obono/ArduinoACePCalendar/doc/schematic.png

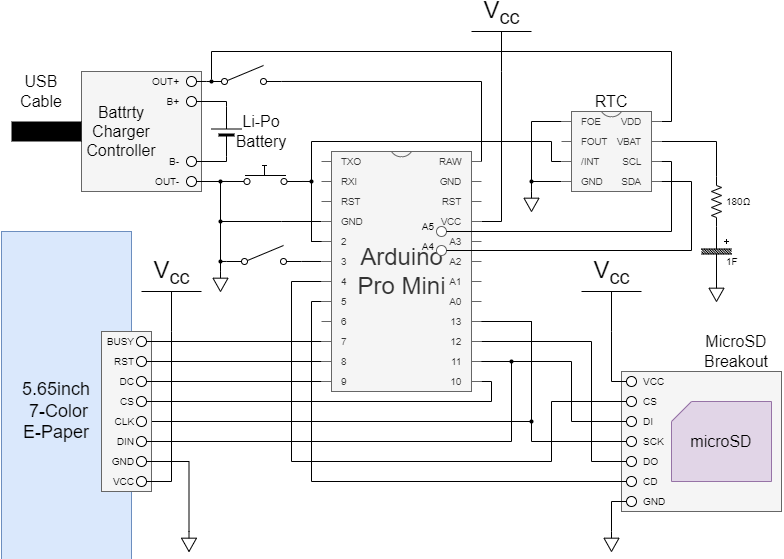
doc/schematic.png
