obono/ArduinoACePCalendar/tools/sample0.jpg

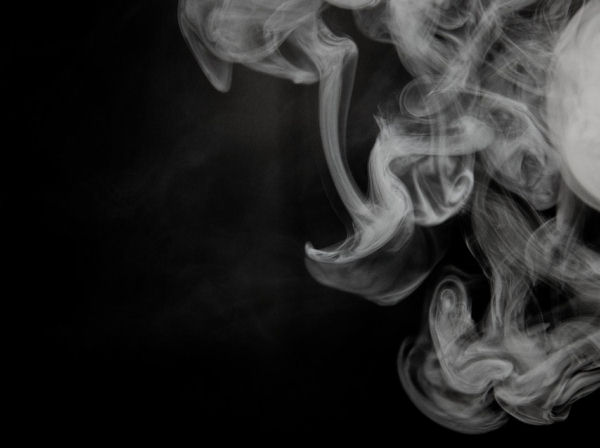
tools/sample0.jpg
