obono/ArduinoACePCalendar/tools/sample1.jpg

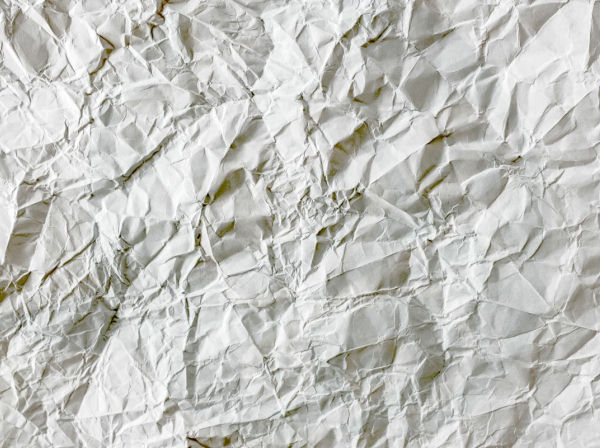
tools/sample1.jpg
