obono/ArduinoACePCalendar/tools/sample2.jpg

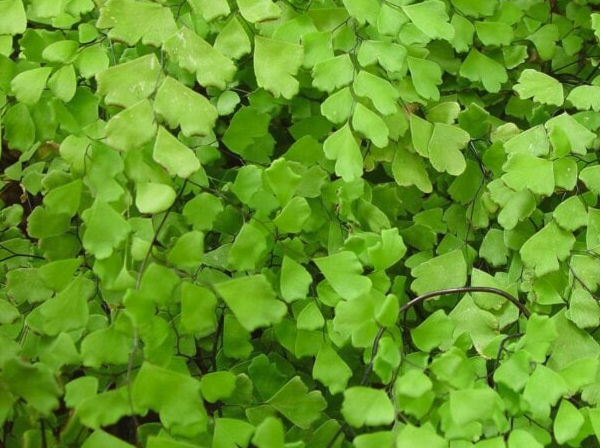
tools/sample2.jpg
