obono/ArduinoACePCalendar/tools/sample3.jpg

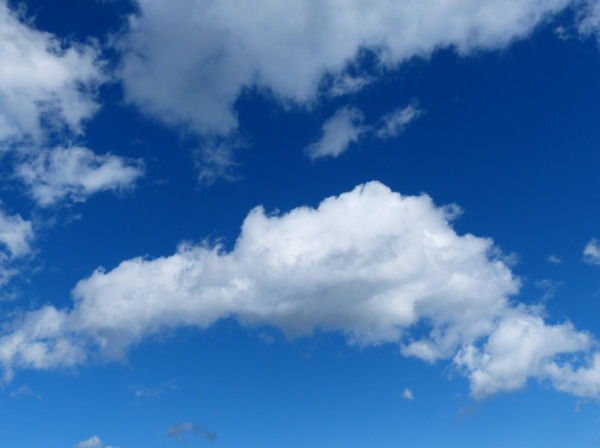
tools/sample3.jpg
