obono/ArduinoACePCalendar/tools/sample4.jpg

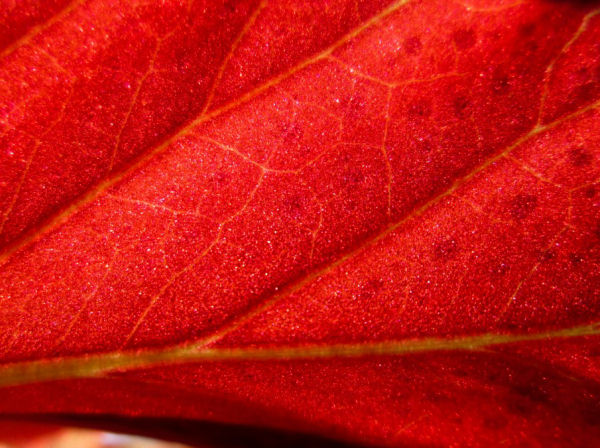
tools/sample4.jpg
