obono/ArduinoACePCalendar/tools/sample5.jpg

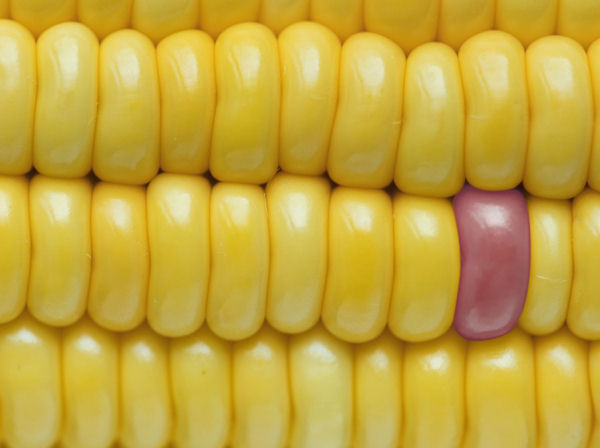
tools/sample5.jpg
