obono/ArduinoACePCalendar/tools/sample6.jpg

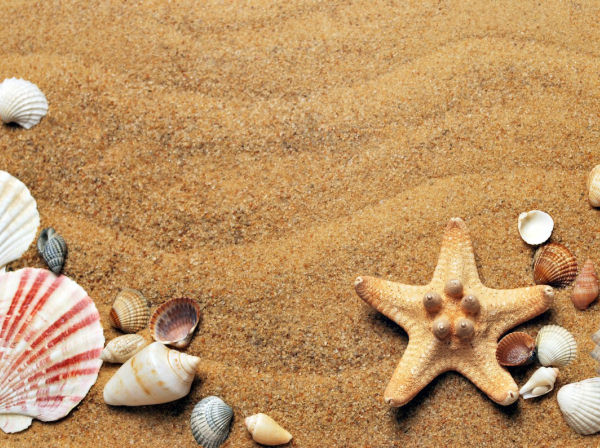
tools/sample6.jpg
