obono/ArduinoACePCalendar/imagedata.h

/**
 * ArduinoACePCalendar : "imagedata.h"
 *
 * Copyright (c) 2022 OBONO
 *
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
 * THE SOFTWARE IS PROVIDED "AS IS", WITHOUT WARRANTY OF ANY KIND, EXPRESS OR
 * IMPLIED, INCLUDING BUT NOT LIMITED TO THE WARRANTIES OF MERCHANTABILITY,
 * FITNESS FOR A PARTICULAR PURPOSE AND NONINFRINGEMENT. IN NO EVENT SHALL THE
 * AUTHORS OR COPYRIGHT HOLDERS BE LIABLE FOR ANY CLAIM, DAMAGES OR OTHER
 * LIABILITY, WHETHER IN AN ACTION OF CONTRACT, TORT OR OTHERWISE, ARISING FROM,
 * OUT OF OR IN CONNECTION WITH THE SOFTWARE OR THE USE OR OTHER DEALINGS IN THE
 * SOFTWARE.
 */

#pragma once

enum : uint8_t {
    IMG_ID_NUMBER_0 = 0,
    IMG_ID_NUMBER_1,
    IMG_ID_NUMBER_2,
    IMG_ID_NUMBER_3,
    IMG_ID_NUMBER_4,
    IMG_ID_NUMBER_5,
    IMG_ID_NUMBER_6,
    IMG_ID_NUMBER_7,
    IMG_ID_NUMBER_8,
    IMG_ID_NUMBER_9,
    IMG_ID_KANJI_SUN,
    IMG_ID_KANJI_MON,
    IMG_ID_KANJI_TUE,
    IMG_ID_KANJI_WED,
    IMG_ID_KANJI_THU,
    IMG_ID_KANJI_FRI,
    IMG_ID_KANJI_SAT,
    IMG_ID_KANJI_YEAR,
    IMG_ID_BRACKET_L,
    IMG_ID_BRACKET_R,
    IMG_ID_KANJI_DAY = IMG_ID_KANJI_SUN,
    IMG_ID_KANJI_MONTH = IMG_ID_KANJI_MON,
    IMG_ID_BLANK = 255,
 };

#define IMG_LETTER_W    32
#define IMG_NUMBER_H    48
#define IMG_KANJI_H     32
#define IMG_KANJI_OFFS  (IMG_NUMBER_H - IMG_KANJI_H)

PROGMEM static const uint8_t imgNumber[10][384] = { // 32x48 (4 pixels / byte) x10
    {
        0x00, 0x00, 0x00, 0x00, 0x00, 0x00, 0x00, 0x00, 0x00, 0x00, 0x00, 0x00, 0x00, 0x00, 0x00, 0x00,
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
        0xE0, 0xFF, 0xFF, 0x2F, 0x00, 0x00, 0x00, 0x00, 0xE0, 0xFF, 0xFF, 0x2F, 0x00, 0x00, 0x00, 0x00,
        0xA0, 0xAA, 0xAA, 0x2A, 0x00, 0x00, 0x00, 0x00, 0x00, 0x00, 0x00, 0x00, 0x00, 0x00, 0x00, 0x00,
    }
};
