obono/ArduinoACePCalendar/testpatterndata.h

/**
 * ArduinoACePCalendar : "testpatterndata.h"
 *
 * Copyright (c) 2022 OBONO
 *
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
 * THE SOFTWARE IS PROVIDED "AS IS", WITHOUT WARRANTY OF ANY KIND, EXPRESS OR
 * IMPLIED, INCLUDING BUT NOT LIMITED TO THE WARRANTIES OF MERCHANTABILITY,
 * FITNESS FOR A PARTICULAR PURPOSE AND NONINFRINGEMENT. IN NO EVENT SHALL THE
 * AUTHORS OR COPYRIGHT HOLDERS BE LIABLE FOR ANY CLAIM, DAMAGES OR OTHER
 * LIABILITY, WHETHER IN AN ACTION OF CONTRACT, TORT OR OTHERWISE, ARISING FROM,
 * OUT OF OR IN CONNECTION WITH THE SOFTWARE OR THE USE OR OTHER DEALINGS IN THE
 * SOFTWARE.
 */

#pragma once

#define IMG_TEST_PATTERN_WIDTH  64
#define IMG_TEST_PATTERN_HEIGHT 64

PROGMEM static const uint8_t imgTestPattern[] = {
    0x66, 0x16, 0x14, 0x11, 0x41, 0x10, 0x00, 0x00, 0x00, 0x00, 0x01, 0x16, 0x11, 0x14, 0x02, 0x11,
    0x11, 0x11, 0x10, 0x00, 0x00, 0x00, 0x01, 0x41, 0x11, 0x41, 0x14, 0x00, 0x00, 0x30, 0x64, 0x14,
    0x43, 0x40, 0x00, 0x04, 0x24, 0x60, 0x06, 0x63, 0x00, 0x00, 0x02, 0x61, 0x62, 0x00, 0x01, 0x11,
    0x11, 0x11, 0x00, 0x36, 0x16, 0x20, 0x04, 0x61, 0x44, 0x14, 0x40, 0x00, 0x46, 0x61, 0x14, 0x63,
    0x00, 0x30, 0x00, 0x00, 0x00, 0x00, 0x01, 0x11, 0x11, 0x11, 0x60, 0x00, 0x00, 0x02, 0x11, 0x11,
    0x11, 0x12, 0x06, 0x15, 0x61, 0x12, 0x00, 0x14, 0x24, 0x00, 0x00, 0x00, 0x11, 0x44, 0x43, 0x00,
    0x62, 0x16, 0x16, 0x16, 0x10, 0x00, 0x00, 0x21, 0x11, 0x11, 0x11, 0x23, 0x21, 0x11, 0x11, 0x11,
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
    0x16, 0x00, 0x00, 0x16, 0x16, 0x11, 0x60, 0x02, 0x62, 0x66, 0x66, 0x20, 0x00, 0x66, 0x55, 0x61,
    0x56, 0x62, 0x66, 0x65, 0x56, 0x60, 0x21, 0x11, 0x16, 0x00, 0x00, 0x00, 0x00, 0x26, 0x61, 0x61,
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
};
