obono/ArduinoACePCalendar/(commit log)

2024-01-27 :memo: Update the schematic
2024-12-16 :+1: Check the pins before initiaizing devices
